5a796d/MINI-4WD-ESP32-Optical-Tachometer/Images/Board 2.jpg

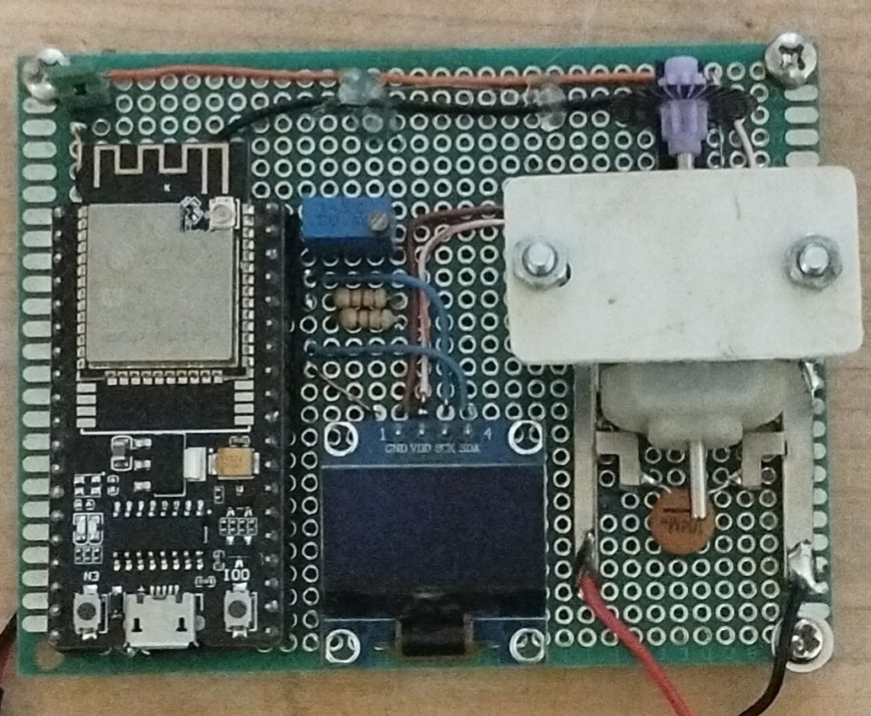
Images/Board 2.jpg
