5a796d/MINI-4WD-ESP32-Optical-Tachometer/Images/Disc.jpg

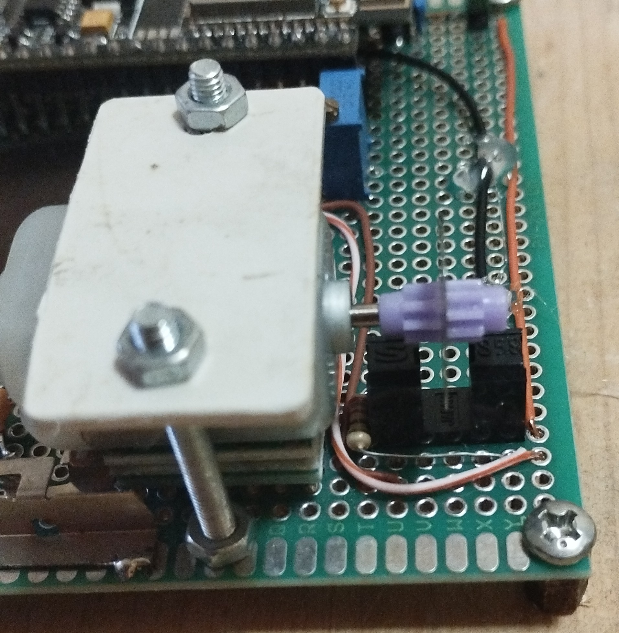
Images/Disc.jpg
