5a796d/MINI-4WD-ESP32-Optical-Tachometer/Images/Board.jpg

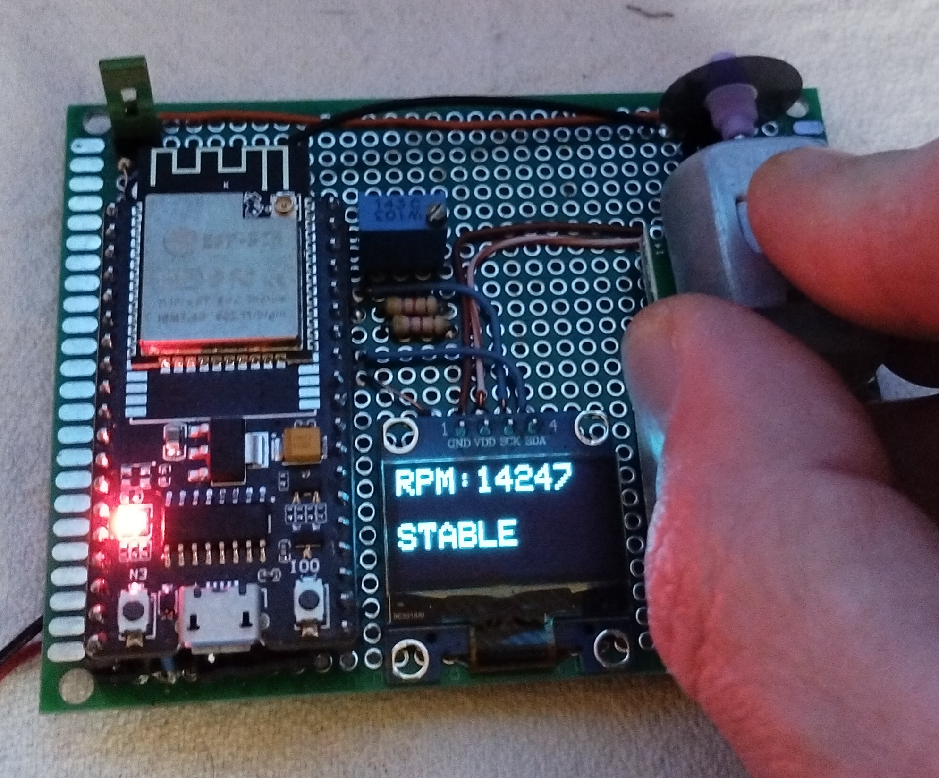
Images/Board.jpg
