5a796d/MINI-4WD-ESP32-Optical-Tachometer/Schematic.png

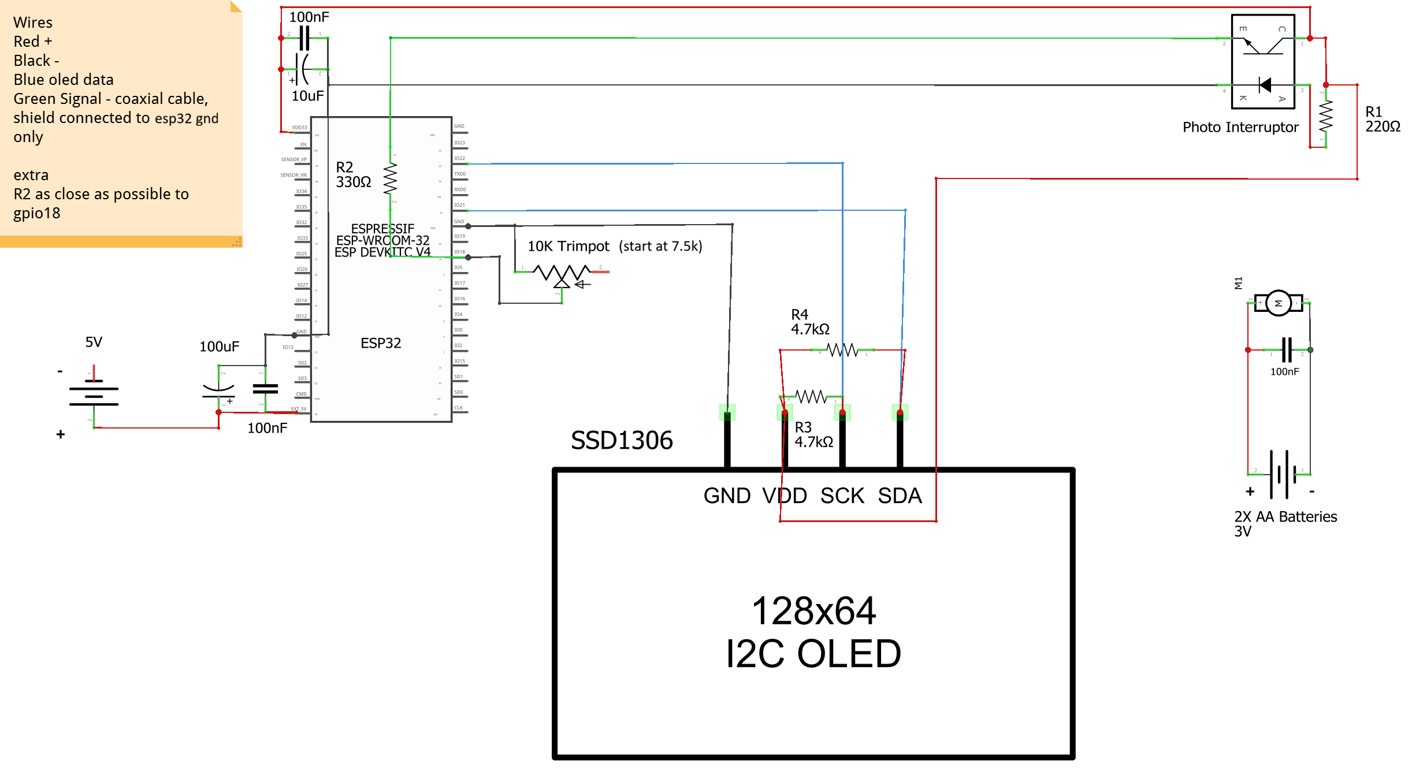
Schematic.png
